dhartkop/ReadyRepRap/Lists & Instructions/170426_schematic-01.jpg

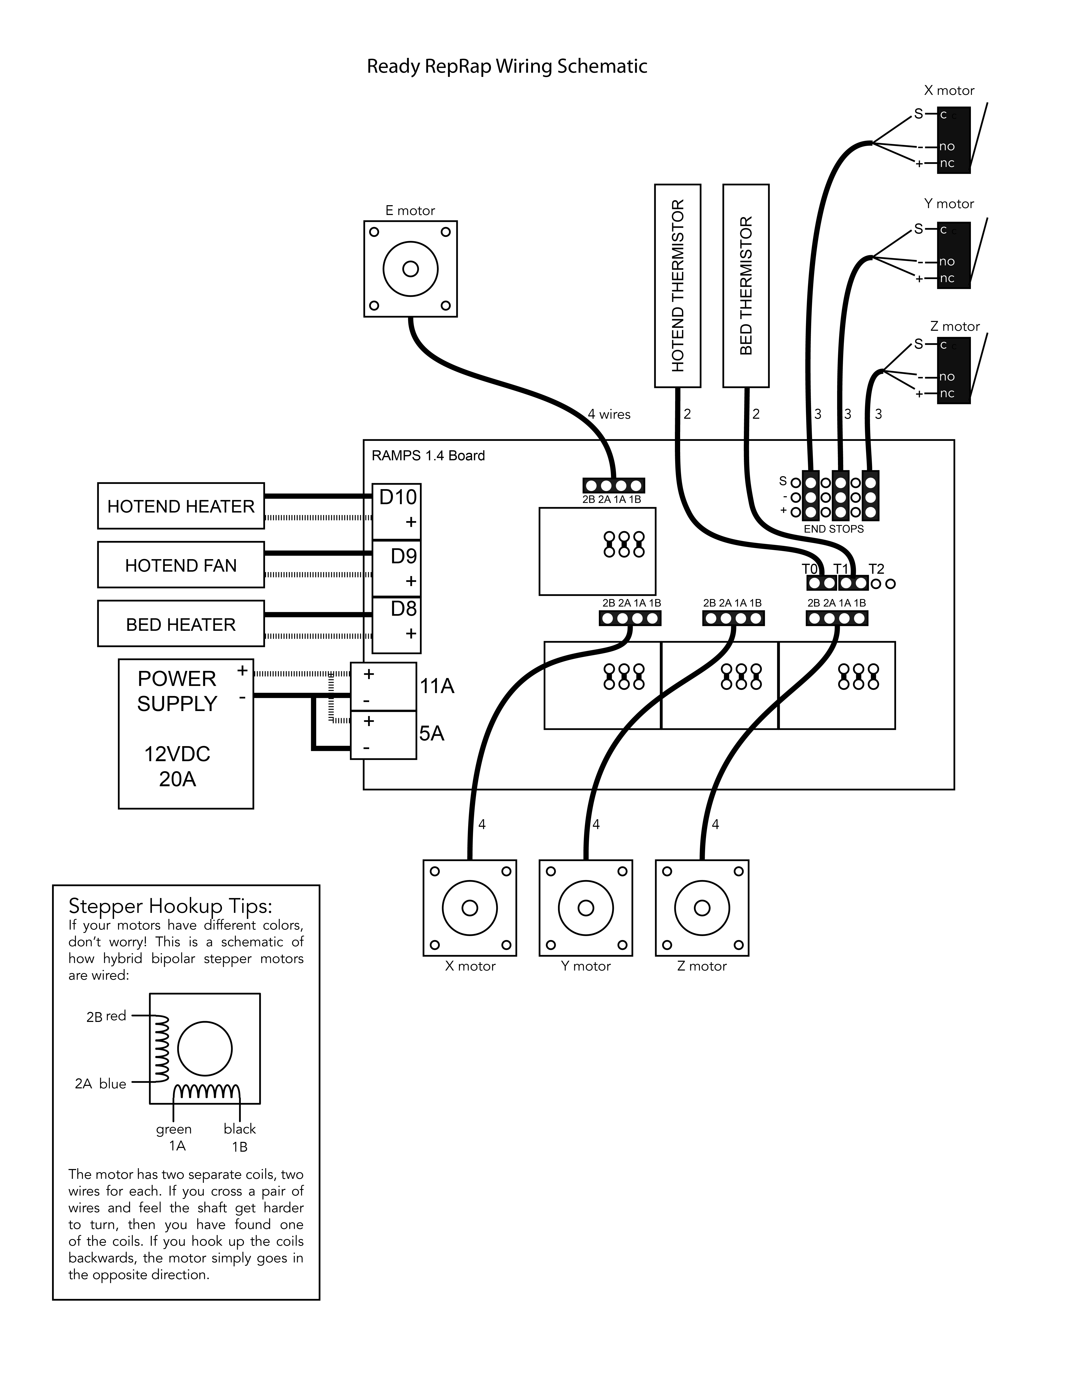
Lists & Instructions/170426_schematic-01.jpg
