dhartkop/ReadyRepRap/Parts to 3D Print/170116_ReadyRepRap_AllParts.stl

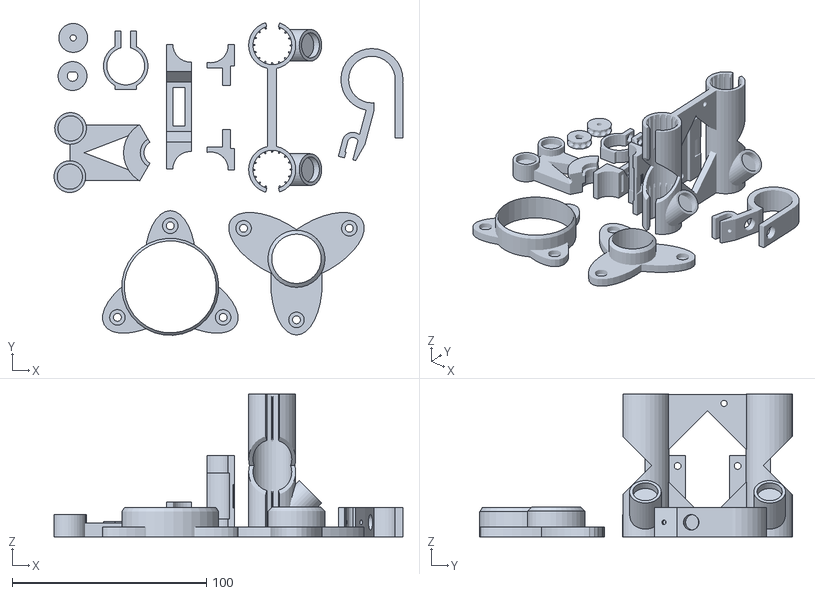
[picture p2: CAD file, 2017-04-26]
Parts to 3D Print/170116_ReadyRepRap_AllParts.stl
179.8 x 161.0 x 73.5
