dhartkop/ReadyRepRap/Parts to 3D Print/170116_ReadyRepRap_SpoolHolder2.stl

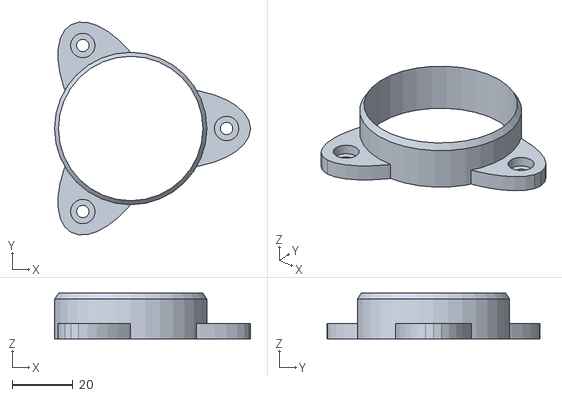
[picture p3: CAD file, 2017-04-26]
Parts to 3D Print/170116_ReadyRepRap_SpoolHolder2.stl
64.3 x 69.7 x 15.0
