dhartkop/ReadyRepRap/Parts to 3D Print/170116_ReadyRepRap_BuildPlate.stl

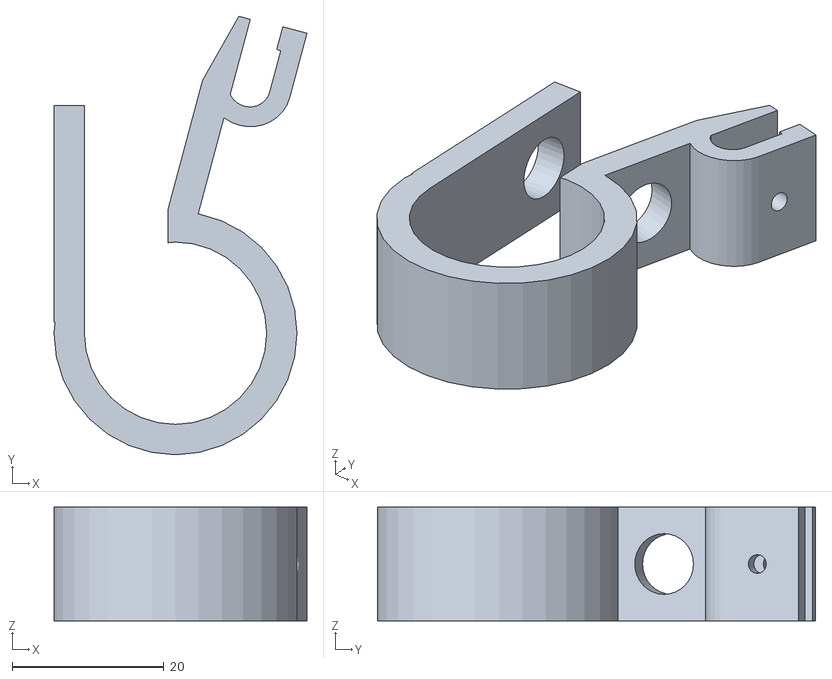
[picture p4: CAD file, 2017-04-26]
Parts to 3D Print/170116_ReadyRepRap_BuildPlate.stl
33.3 x 57.7 x 15.0
