dhartkop/ReadyRepRap/Parts to 3D Print/170116_ReadyRepRap_Carriage.stl

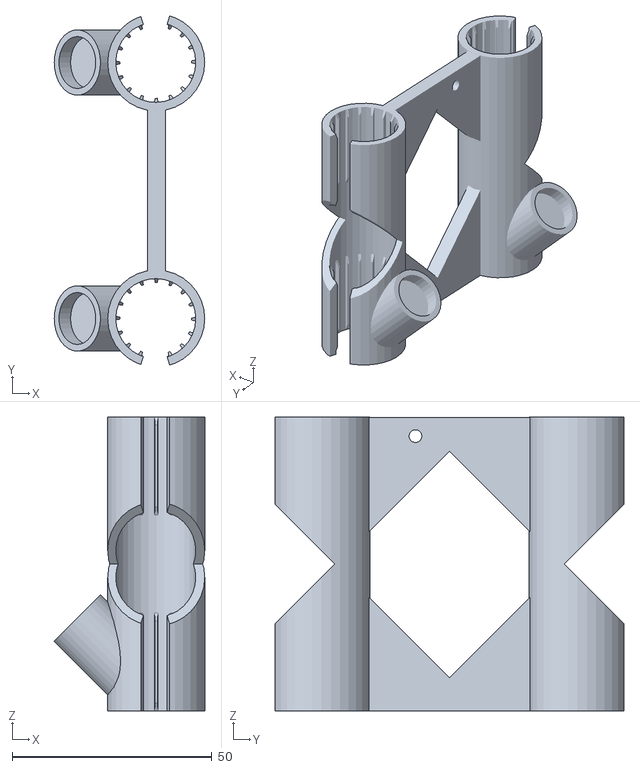
[picture p5: CAD file, 2017-04-26]
Parts to 3D Print/170116_ReadyRepRap_Carriage.stl
37.7 x 87.3 x 73.5
