dhartkop/ReadyRepRap/Parts to 3D Print/170116_ReadyRepRap_Pulleys.stl

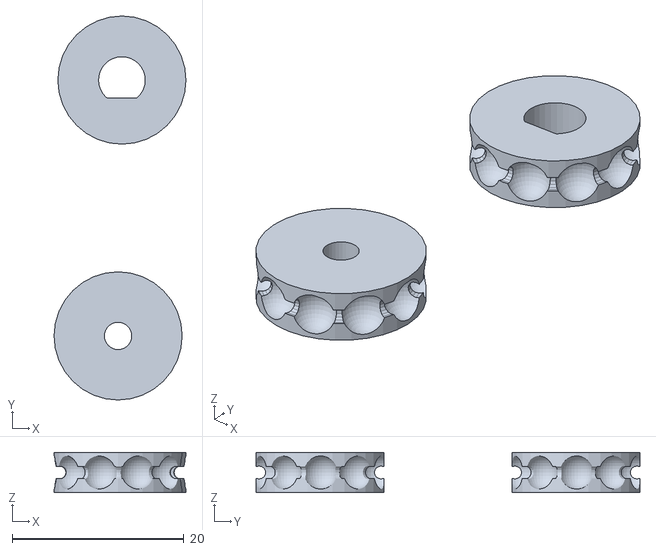
[picture p6: CAD file, 2017-04-26]
Parts to 3D Print/170116_ReadyRepRap_Pulleys.stl
15.4 x 44.7 x 4.71
