dhartkop/ReadyRepRap/Parts to 3D Print/170116_ReadyRepRap_Motor.stl

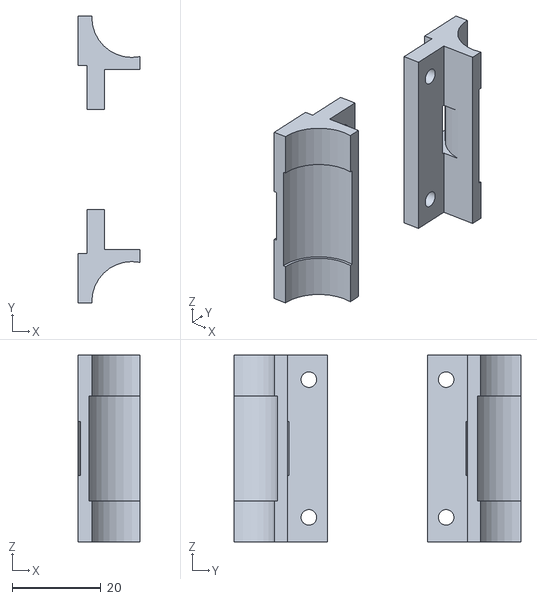
[picture p7: CAD file, 2017-04-26]
Parts to 3D Print/170116_ReadyRepRap_Motor.stl
14.0 x 64.6 x 42.0
