dhartkop/ReadyRepRap/Parts to 3D Print/170116_ReadyRepRap_Endstop.stl

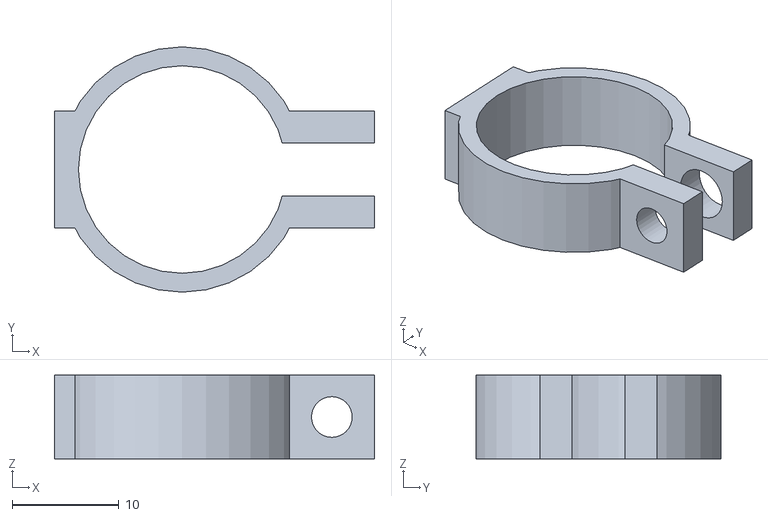
[picture p8: CAD file, 2017-04-26]
Parts to 3D Print/170116_ReadyRepRap_Endstop.stl
30.0 x 23.0 x 7.84
