dhartkop/ReadyRepRap/Parts to 3D Print/170116_ReadyRepRap_Idler.stl

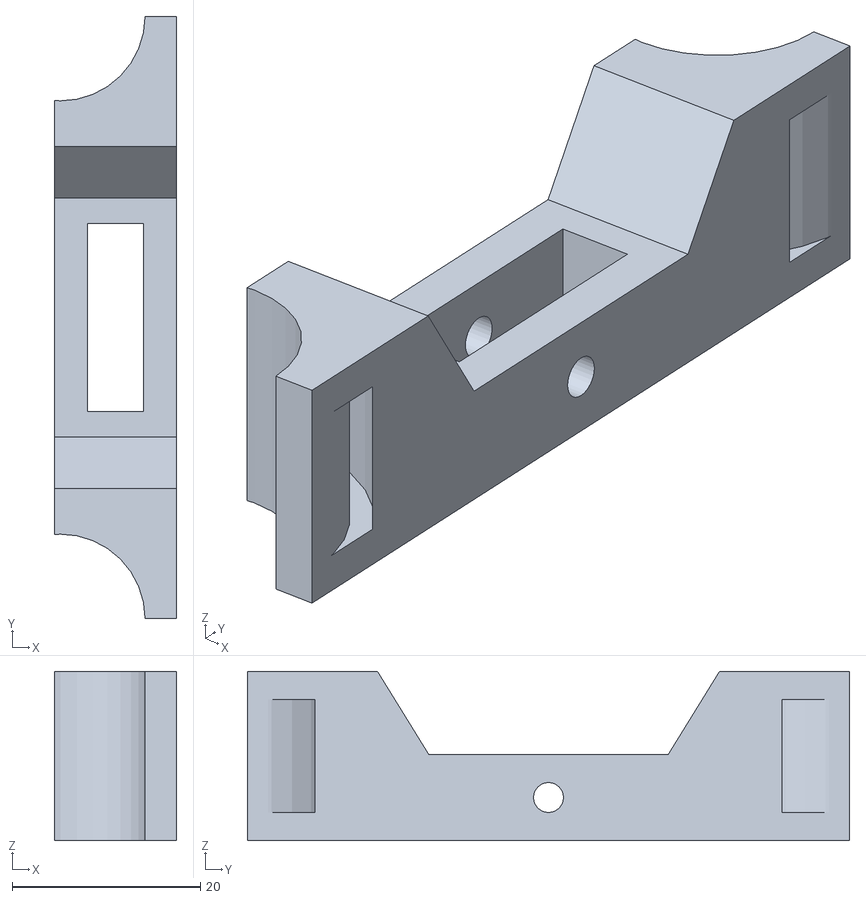
[picture p9: CAD file, 2017-04-26]
Parts to 3D Print/170116_ReadyRepRap_Idler.stl
13.0 x 64.0 x 18.0
