dhartkop/ReadyRepRap/Parts to 3D Print/170116_ReadyRepRap_Hotend.stl

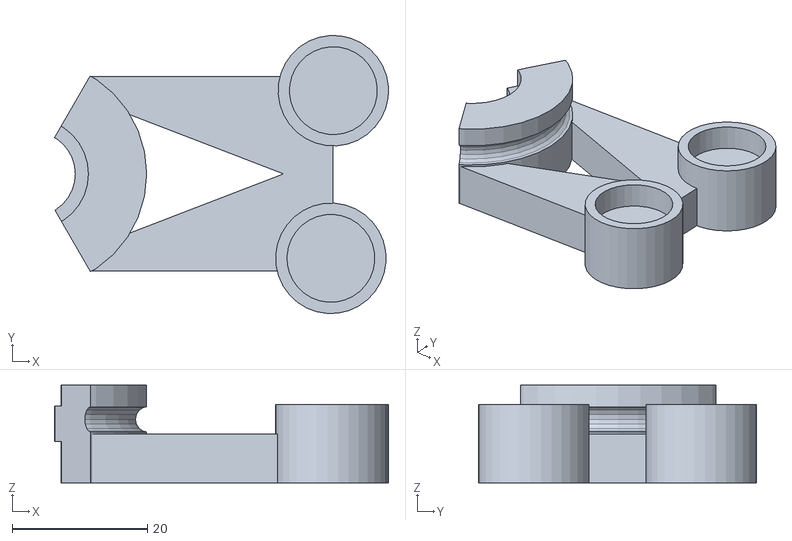
[picture p10: CAD file, 2017-04-26]
Parts to 3D Print/170116_ReadyRepRap_Hotend.stl
49.4 x 41.1 x 14.5
