dhartkop/ReadyRepRap/Parts to 3D Print/170116_ReadyRepRap_SpoolHolder1.stl

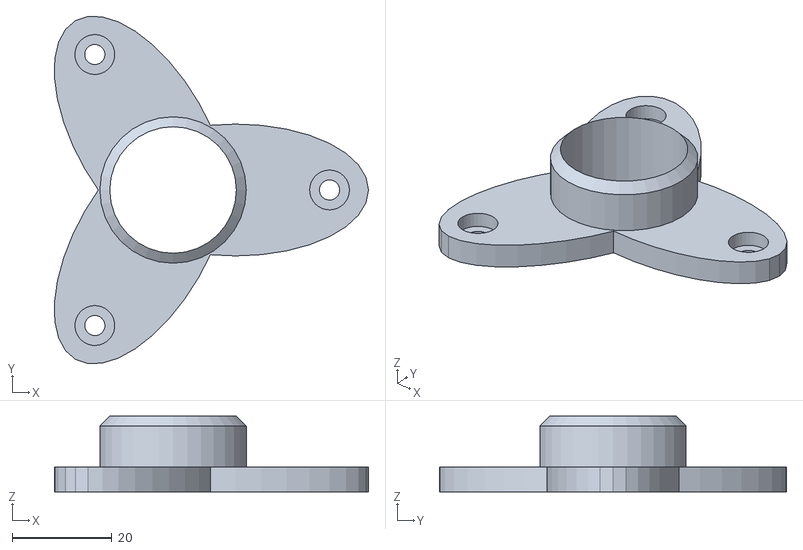
[picture p11: CAD file, 2017-04-26]
Parts to 3D Print/170116_ReadyRepRap_SpoolHolder1.stl
63.1 x 69.7 x 15.3
