dhartkop/ReadyRepRap/Firmware & Software/Printrun configs/PrintrunScreenshot1.png

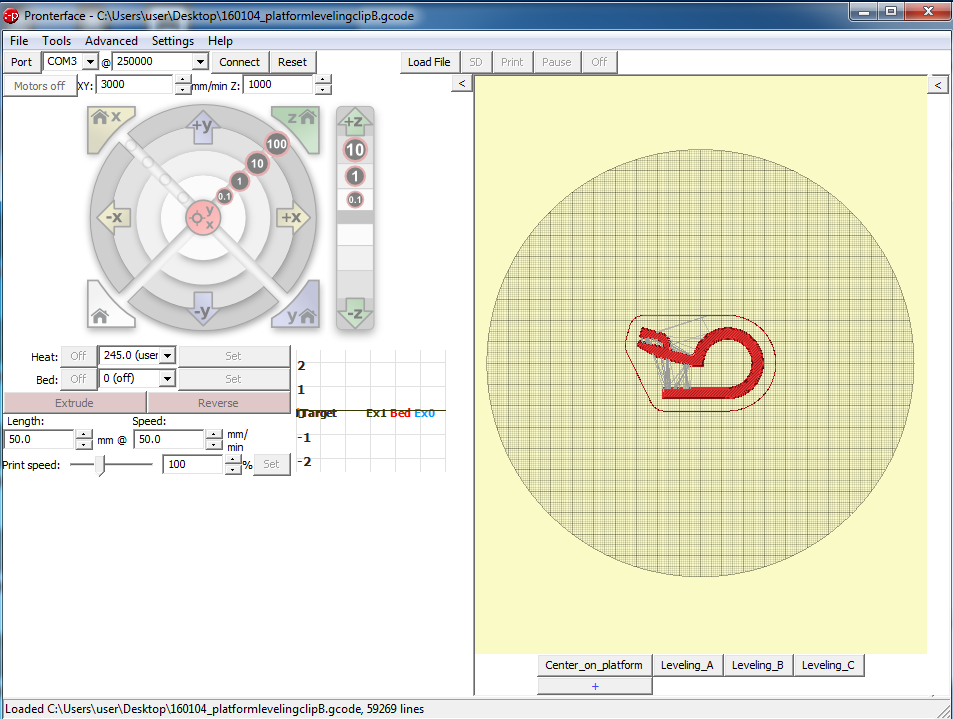
Firmware & Software/Printrun configs/PrintrunScreenshot1.png
