dhartkop/ReadyRepRap/Firmware & Software/Printrun configs/PrintrunScreenshot2.png

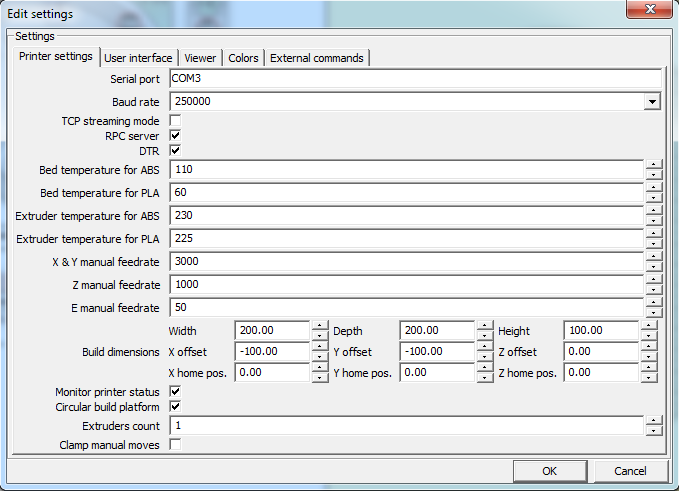
Firmware & Software/Printrun configs/PrintrunScreenshot2.png
