dhartkop/ReadyRepRap/Lists & Instructions/170426_boxLayoutTemplate-01.jpg

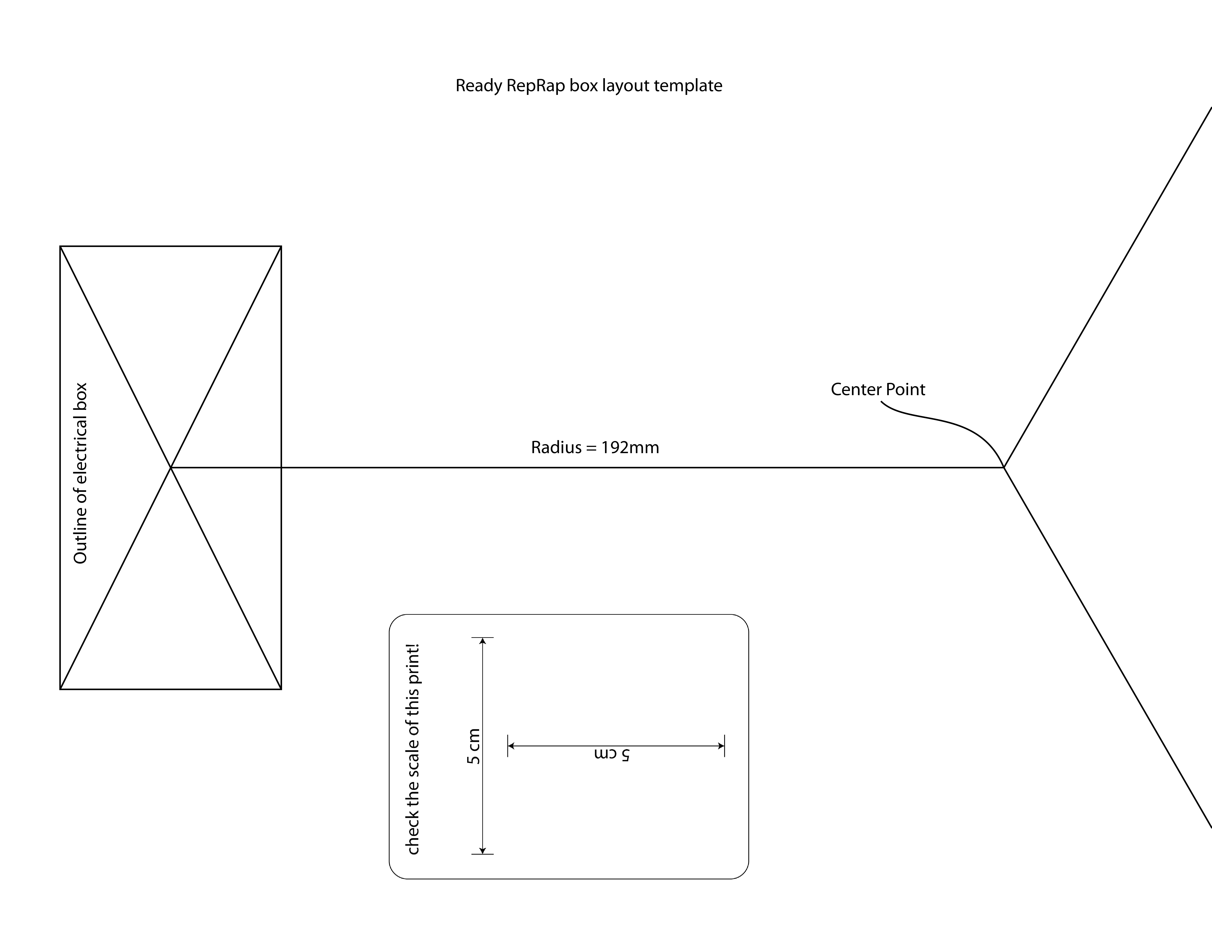
Lists & Instructions/170426_boxLayoutTemplate-01.jpg
