dhartkop/ReadyRepRap/Firmware & Software/Firmware/Marlin/Configuration.h

#define CONFIGURATION_H
#include "boards.h"
#include "macros.h"
#if ENABLED(USE_AUTOMATIC_VERSIONING)
  #include "_Version.h"
#else
  #include "Default_Version.h"
#endif
#define STRING_CONFIG_H_AUTHOR "(none, default config)" // Who made the changes.
#define SHOW_BOOTSCREEN
#define STRING_SPLASH_LINE1 SHORT_BUILD_VERSION // will be shown during bootup in line 1
#define SERIAL_PORT 0
#define BAUDRATE 250000
  #define MOTHERBOARD BOARD_RAMPS_13_EFB
#define CUSTOM_MACHINE_NAME "ReadyRepRap"
#define EXTRUDERS 1
#define POWER_SUPPLY 1
#define TEMP_SENSOR_0 5
#define TEMP_SENSOR_1 0
#define TEMP_SENSOR_2 0
#define TEMP_SENSOR_3 0
#define TEMP_SENSOR_BED 1
#define MAX_REDUNDANT_TEMP_SENSOR_DIFF 10
#define TEMP_RESIDENCY_TIME 10  // (seconds)
#define TEMP_HYSTERESIS 3       // (degC) range of +/- temperatures considered "close" to the target one
#define TEMP_WINDOW     1       // (degC) Window around target to start the residency timer x degC early.
#define HEATER_0_MINTEMP 5
#define HEATER_1_MINTEMP 5
#define HEATER_2_MINTEMP 5
#define HEATER_3_MINTEMP 5
#define BED_MINTEMP 5
#define HEATER_0_MAXTEMP 275
#define HEATER_1_MAXTEMP 275
#define HEATER_2_MAXTEMP 275
#define HEATER_3_MAXTEMP 275
#define BED_MAXTEMP 150
#define PIDTEMP
#define BANG_MAX 255 // limits current to nozzle while in bang-bang mode; 255=full current
#define PID_MAX BANG_MAX // limits current to nozzle while PID is active (see PID_FUNCTIONAL_RANGE below); 255=full current
  #define PID_FUNCTIONAL_RANGE 10 // If the temperature difference between the target temperature and the actual temperature
  #define PID_INTEGRAL_DRIVE_MAX PID_MAX  //limit for the integral term
  #define K1 0.95 //smoothing factor within the PID
  #define  DEFAULT_Kp 22.2
  #define  DEFAULT_Ki 1.08
  #define  DEFAULT_Kd 114
#define MAX_BED_POWER 255 // limits duty cycle to bed; 255=full current
#define PREVENT_DANGEROUS_EXTRUDE
#define PREVENT_LENGTHY_EXTRUDE
#define EXTRUDE_MINTEMP 170
#define EXTRUDE_MAXLENGTH (X_MAX_LENGTH+Y_MAX_LENGTH) //prevent extrusion of very large distances.
#define THERMAL_PROTECTION_HOTENDS // Enable thermal protection for all extruders
#define THERMAL_PROTECTION_BED     // Enable thermal protection for the heated bed
#define DELTA
  #define DELTA_SEGMENTS_PER_SECOND 200
  #define DELTA_DIAGONAL_ROD 322.0 // mm - new measure as of 2015-12-30
  #define DELTA_SMOOTH_ROD_OFFSET 181.5 // mm - new measure as of 2015-12-30
  #define DELTA_EFFECTOR_OFFSET 35.5 // mm - new measure as of 2015-12-30
  #define DELTA_CARRIAGE_OFFSET 15.75 // mm - new measure as of 2015-12-30
  #define DELTA_RADIUS (DELTA_SMOOTH_ROD_OFFSET-DELTA_EFFECTOR_OFFSET-DELTA_CARRIAGE_OFFSET)
  #define DELTA_PRINTABLE_RADIUS 140
  #define ENDSTOPPULLUP_XMAX
  #define ENDSTOPPULLUP_YMAX
  #define ENDSTOPPULLUP_ZMAX
  #define ENDSTOPPULLUP_ZMIN_PROBE
const bool X_MIN_ENDSTOP_INVERTING = true; // set to true to invert the logic of the endstop.
const bool Y_MIN_ENDSTOP_INVERTING = true; // set to true to invert the logic of the endstop.
const bool Z_MIN_ENDSTOP_INVERTING = true; // set to true to invert the logic of the endstop.
const bool X_MAX_ENDSTOP_INVERTING = true; // set to true to invert the logic of the endstop.
const bool Y_MAX_ENDSTOP_INVERTING = true; // set to true to invert the logic of the endstop.
const bool Z_MAX_ENDSTOP_INVERTING = true; // set to true to invert the logic of the endstop.
const bool Z_MIN_PROBE_ENDSTOP_INVERTING = true; // set to true to invert the logic of the endstop.
#define DISABLE_MIN_ENDSTOPS // Deltas only use min endstops for probing.
#define X_ENABLE_ON 0
#define Y_ENABLE_ON 0
#define Z_ENABLE_ON 0
#define E_ENABLE_ON 0 // For all extruders
#define DISABLE_X false
#define DISABLE_Y false
#define DISABLE_Z false
#define DISABLE_E false // For all extruders
#define DISABLE_INACTIVE_EXTRUDER true //disable only inactive extruders and keep active extruder enabled
#define INVERT_X_DIR false // DELTA does not invert
#define INVERT_Y_DIR false
#define INVERT_Z_DIR false
#define INVERT_E0_DIR false
#define INVERT_E1_DIR false
#define INVERT_E2_DIR false
#define INVERT_E3_DIR false
#define X_HOME_DIR 1  // deltas always home to max
#define Y_HOME_DIR 1
#define Z_HOME_DIR 1
#define min_software_endstops true // If true, axis won't move to coordinates less than HOME_POS.
#define max_software_endstops true  // If true, axis won't move to coordinates greater than the defined lengths below.
#define X_MIN_POS -DELTA_PRINTABLE_RADIUS
#define Y_MIN_POS -DELTA_PRINTABLE_RADIUS
#define Z_MIN_POS 0
#define X_MAX_POS DELTA_PRINTABLE_RADIUS
#define Y_MAX_POS DELTA_PRINTABLE_RADIUS
#define Z_MAX_POS MANUAL_Z_HOME_POS
#define DEBUG_LEVELING_FEATURE
  #define AUTO_BED_LEVELING_GRID  // Deltas only support grid mode.
    #define DELTA_PROBABLE_RADIUS (DELTA_PRINTABLE_RADIUS - 100)
    #define LEFT_PROBE_BED_POSITION -DELTA_PROBABLE_RADIUS
    #define RIGHT_PROBE_BED_POSITION DELTA_PROBABLE_RADIUS
    #define FRONT_PROBE_BED_POSITION -DELTA_PROBABLE_RADIUS
    #define BACK_PROBE_BED_POSITION DELTA_PROBABLE_RADIUS
    #define MIN_PROBE_EDGE 10 // The Z probe square sides can be no smaller than this.
    #define AUTO_BED_LEVELING_GRID_POINTS 7
  #define X_PROBE_OFFSET_FROM_EXTRUDER 0     // Z probe to nozzle X offset: -left  +right
  #define Y_PROBE_OFFSET_FROM_EXTRUDER -10   // Z probe to nozzle Y offset: -front +behind
  #define Z_PROBE_OFFSET_FROM_EXTRUDER -1  // Z probe to nozzle Z offset: -below (always!)
  #define Z_RAISE_BEFORE_HOMING 4       // (in mm) Raise Z axis before homing (G28) for Z probe clearance.
  #define XY_TRAVEL_SPEED 4000         // X and Y axis travel speed between probes, in mm/min.
  #define Z_RAISE_BEFORE_PROBING 15   // How much the Z axis will be raised before traveling to the first probing point.
  #define Z_RAISE_BETWEEN_PROBINGS 5  // How much the Z axis will be raised when traveling from between next probing points
  #define Z_RAISE_AFTER_PROBING 50    // How much the Z axis will be raised after the last probing point.
  #define Z_SAFE_HOMING   // This feature is meant to avoid Z homing with Z probe outside the bed area.
    #define Z_SAFE_HOMING_X_POINT ((X_MIN_POS + X_MAX_POS) / 2)    // X point for Z homing when homing all axis (G28).
    #define Z_SAFE_HOMING_Y_POINT ((Y_MIN_POS + Y_MAX_POS) / 2)    // Y point for Z homing when homing all axis (G28).
#define Z_MIN_PROBE_ENDSTOP
#define MANUAL_HOME_POSITIONS  // If defined, MANUAL_*_HOME_POS below will be used
  #define MANUAL_X_HOME_POS 0
  #define MANUAL_Y_HOME_POS 0
  #define MANUAL_Z_HOME_POS 300 // For delta: Distance between nozzle and print surface after homing.
#define HOMING_FEEDRATE_XYZ (200*60)
#define HOMING_FEEDRATE_E 0
#define HOMING_FEEDRATE { HOMING_FEEDRATE_XYZ, HOMING_FEEDRATE_XYZ, HOMING_FEEDRATE_XYZ, HOMING_FEEDRATE_E }
#define DEFAULT_AXIS_STEPS_PER_UNIT   {73.157, 73.157, 73.157, 503.45}
#define DEFAULT_MAX_FEEDRATE          {250, 250, 250, 25}    // (mm/sec)
#define DEFAULT_MAX_ACCELERATION      {9000,9000,9000,10000}    // X, Y, Z, E maximum start speed for accelerated moves. E default values are good for skeinforge 40+, for older versions raise them a lot.
#define DEFAULT_ACCELERATION          3000    // X, Y, Z and E acceleration in mm/s^2 for printing moves
#define DEFAULT_RETRACT_ACCELERATION  3000    // E acceleration in mm/s^2 for retracts
#define DEFAULT_TRAVEL_ACCELERATION   3000    // X, Y, Z acceleration in mm/s^2 for travel (non printing) moves
#define DEFAULT_XYJERK                20.0    // (mm/sec)
#define DEFAULT_ZJERK                 20.0    // (mm/sec) Must be same as XY for delta
#define DEFAULT_EJERK                 5.0     // (mm/sec)
#define CUSTOM_M_CODES
#define PLA_PREHEAT_HOTEND_TEMP 180
#define PLA_PREHEAT_HPB_TEMP 70
#define PLA_PREHEAT_FAN_SPEED 255   // Insert Value between 0 and 255
#define ABS_PREHEAT_HOTEND_TEMP 240
#define ABS_PREHEAT_HPB_TEMP 100
#define ABS_PREHEAT_FAN_SPEED 255   // Insert Value between 0 and 255
#define LANGUAGE_INCLUDE GENERATE_LANGUAGE_INCLUDE(en)
  #define DISPLAY_CHARSET_HD44780_JAPAN        // this is the most common hardware
#define SOFT_PWM_SCALE 0
#define FILAMENT_SENSOR_EXTRUDER_NUM 0   //The number of the extruder that has the filament sensor (0,1,2)
#define MEASUREMENT_DELAY_CM        14   //measurement delay in cm.  This is the distance from filament sensor to middle of barrel
#define DEFAULT_NOMINAL_FILAMENT_DIA 3.00  //Enter the diameter (in mm) of the filament generally used (3.0 mm or 1.75 mm) - this is then used in the slicer software.  Used for sensor reading validation
#define MEASURED_UPPER_LIMIT         3.30  //upper limit factor used for sensor reading validation in mm
#define MEASURED_LOWER_LIMIT         1.90  //lower limit factor for sensor reading validation in mm
#define MAX_MEASUREMENT_DELAY       20     //delay buffer size in bytes (1 byte = 1cm)- limits maximum measurement delay allowable (must be larger than MEASUREMENT_DELAY_CM  and lower number saves RAM)
#define DEFAULT_MEASURED_FILAMENT_DIA  DEFAULT_NOMINAL_FILAMENT_DIA  //set measured to nominal initially
#include "Configuration_adv.h"
#include "thermistortables.h"
