dhartkop/ReadyRepRap/(commit log)

2017-04-26 Sorting files into place
    [170116_ReadyRepRap_AllParts.stl, 170116_ReadyRepRap_BuildPlate.stl, 170116_ReadyRepRap_Carriage.stl, 170116_ReadyRepRap_Endstop.stl, 170116_ReadyRepRap_Hotend.stl, 170116_ReadyRepRap_Idler.stl, 170116_ReadyRepRap_Motor.stl, 170116_ReadyRepRap_Pulleys.stl]
2024-03-07 PDF book includes illustrated assembly instructions
